enricferrera/PEMY/Fase_Inicial/Calculos_dron.pdf

## Cálculos para estos componentes

Qué tenemos?
Motor brushless A22-12:
- 1000KV -> Cada voltio girará 1000 rpm
- 22mm width of the stator
- 13mm height of the rotor

ESC (Electrónic Speed Controller):
- 30A

Propeller 10-45:
- Diameter: 10 inches → 25,4 cm
- Pitch 4.5 inches → 11.43

Battery 2 options:
- Batería Lipo 3500mAh 2S 25C, 7.4V
- 3500mAh
- 7,4V
- 2s
- 25C → 3,5A*25(1/h) = 87,5A (Max Amp output)
- Energia = 3.5 Ah * 7.4V = 25.9 Wh
- Lipo Batería 5200mAh 2S 50C 7.4V
- 5200mAh
- 7,4V
- 2s
- 50C → 5,2A*50(1/h) = 260A (Max Amp output)
- Energia = 5.2 Ah * 7.4V = 38.48 Wh
Weight: 1kg

## ¿Volará?

Peso del dron

Componente | Peso
RaspBerry pi 4 | 10g
Cámara con autofocus 12MP IMX477 | 5g
Motor brushless * 4 | 120*4 = 480g
Batería Lipo 3500mAh 2S 25C, 7.4V | 215g
Omnibus F4V3S F4 V3 V3S PLUS FC | 18g
Carcasa | 250g
TOTAL: | 978 - aprox 1 kg

## Thrust-to-Weight Ratio (T:W)

Thrust:
1. Determine motor rpm:
- KV: Motor KV Rating
- V: Battery voltage
Formula: KV ⋅ V = RPM → KV = 1000kv · 7,4V = 7400RPM
2. Calculate propeller thrust

T ≈ CT ⋅ ρ ⋅ n

2 ⋅ D

4

Where:

- T: Thrust in Newtons
- CT: Thrust coefficient (typically ranges from 0.1 to 0.2 for common
| hobby props)
- ρ: Air density (approx 1.225 kg/m3 at sea level)
- n: Rotational speed in revolutions per second (RPS)
- D: Propeller diameter in meters

RPM to RPSecond = 7400/60 = 123,33

Ct = 0.15
p = 1.225
n = 123
D = 0.25

T = 0,15 * 1.225 * 123 ^ 2 * 0.25 ^ 4 = 11,57 N

Convert thrust to kilograms (1Kg = 9.81N)
14,47 / 9,81 = 1,179kg

Total thrust for 4 motors = 1,352kg * 4 = 4.6996kg

Thrust to weight ratio = 4.6kg / 1kg = 4.6kg

# Induced Velocity at Hover (vi,h )

Weight (m): 1kg (1000g from our example above)

Propeller Radius (rprop

): 0.125 (0.25 diameter from our 10" example above/2)

Air Density (ρ): 1.225 kg/m³ (approx at sea level)

Gravitational Force (g): 9.81 m/s

2
(constant)

Number of Rotors (Nr): 4 (4 total motors)

## Step-by-step calculation:

Formula: vi,h

= √ ( Th
/ 2ρAprop

) = √ (mg / 2ρπr
2
propNr)

### 1. Calculate the Thrust Required to Hover (Th):

Th = mg = 1 ⋅ 9.81 ≈ 9.81 N

### 2. Calculate the Propeller Area (Aprop):

Aprop = πr

2

prop = π(0.125)² ≈ π ⋅ 0.015625 = 0.049087 m²

### 3. Insert the Values into the Formula:

vi,h

= √ 9.81/ 2 ⋅ 1.225 ⋅ π ⋅ 0.015625 ⋅ 4

Simplify for Induced Velocity at Hover:

vi,h

= √ 6.867 / 0.48105 ≈ √16.81 ≈ 4.51 m/s

# 3. Hover Power (Ph )

## What variables do you need:

Weight (m): 1 (1000g from our example above)

Gravitational Force (g): 9.81 m/s²
(constant)

Air Density (ρ): 1.225 kg/m³ (approx at sea level)

Propeller Radius (rprop

): 0.125 (0.13 diameter from our 5" example above/2)

Number of Rotors (Nr): 4 (4 total motors)

Propeller Efficiency (ηP): 0.6 (typical assumption for small multicopter propellers)

Thrust Required to Hover (Th

): 9,81N (calculated from previous formula)

Induced Velocity at Hover (vi,h

): 4.51 m/s (calculated from previous formula)

## Step-by-step calculation:

Formula: Ph = Thvi,hNr / ηP

### 1. Insert Values into the Formula:

Ph = (9,81 ⋅ 4.51 ⋅ 4) / 0.6

### 2. Simplify for Hover Power:

Ph = 176.97 / 0.6 ≈ 294.95 W

# 4. Power at Optimal Endurance (Pe ) and Optimal Range (Pr )

Hover power: 294.95W (calculated above)

Power consumption for optimal endurance: 91.4% (constant derived from studies and experiments on multicopter performance)

Power consumption for optimal range: 109.2% (constant derived from studies and experiments on multicopter performance)

## Step-by-step calculation:

### 1. Calculate Power at Optimal Endurance (Pe

):

Pe = 0.914 ⋅ 294.95 ≈ 269.58 W

### 2. Calculate Power at Optimal Range (Pr ):

Pr = 1.092 ⋅ 294.95 ≈ 322.08 W

# 5. Electric Power Demand (Pmot,e

),

### (Pmot,r )

## What variables do you need:

Power at Optimal Endurance (Pe

): 269.58 W (calculated above)

Power at Optimal Range (Pr ): 322.08 W (calculated above)

Motor Efficiency (ηM): 0.75 (assumed, typical value for electric motors)

## Step-by-step calculation:

### 1. Calculate Electric Power Demand at Optimal Endurance (Pmot,e

):

Formula: (Pmot,e

) = Pe

/ ηM

Insert values into formula:

(Pmot,e

) = 269.58 / 0.75 ≈ 359.44 W

### 2. Calculate Electric Power Demand at Optimal Range (Pmot,r):

Formula: (Pmot,r) = Pr / ηM

Insert values into formula:

(Pmot,r) = 322.08 / 0.75 ≈ 429.44 W

# 6. Normalized Power Consumption (Pcell,e

), (Pcell,r )

## What variables do you need:

Power Demand at Optimal Endurance (Pmot,e

): 359.44W (calculated
above)

Power Demand at Optimal Range (Pmot,r): 429.44 W (calculated above)

Battery Cell Count (Ncell): 2 (based on the battery we picked)

Battery Capacity (Cbatt): 3500 mAh (based on the battery we picked)

## Step-by-step calculation:

### 1. Convert Battery Capacity from mAh to Ah:

Cbatt = 3500 mAh / 1000 = 3.5 Ah

### 2. Calculate Normalized Power Consumption at Optimal Endurance

(Pcell,e

):

Formula: Pcell,e = Pmot,e

/ (Ncell ⋅ Cbatt )

Insert values into formula:

Pcell,e = 359.44 / (2 ⋅ 3.5 ) = 359.4/ 7 ≈ 51.34 W / Ah

3 . Calculate Normalized Power Consumption at Optimal Range (Pcell,r):

Formula: Pcell,r = Pmot,r / (Ncell ⋅ Cbatt )

Insert values into formula:

Pcell,r = 429.44/ (2 ⋅ 3.5 ) = 429.44 / 7 ≈ 61.34 W / Ah

# 7. Effective Battery Capacity (κe

),
(κr )

## What variables do you need:

Normalized Power Consumption at Optimal Endurance (Pcell,e

): 51.34 W
/ Ah (calculated above)

Calculate Normalized Power Consumption at Optimal Range (Pcell,r): 61.34 W / Ah (calculated above)

Polynomial coefficients for effective capacity (assumed, based on empirical data)
d0

: Constant term = 1.0
d1

: Linear term coefficient = -0.01
d2

: Quadratic term coefficient = 0.0005 d3

: Cubic term coefficient = -0.00001

## Step-by-step calculation:

### 1. Calculate Battery Capacity at Optimal Endurance (κe

):

Formula: κe = d0 + d1Pcell,e + d2P

2
cell,e + d

3
cell,e

Insert values into formula:
κe = 1.0 + (-0.01 ⋅ 51.34) + (0.0005 ⋅ 51.34²

) + (-0.00001 ⋅ 51.34³
)

Simplify:
κe = 1 - 0.5134 + 1.3178 - 1.3532≈ 0.4512

### 2. Calculate Battery Capacity at Optimal Range (κr):

Formula: κr = d0 + d1Pcell,r + d2P

2
cell,r + d

3
cell,r

Insert values into formula:
κr = 1.0 + (-0.01 ⋅ 61.34) + (0.0005 ⋅ 61.34²

) + (-0.00001 ⋅ 61.34³
)

Simplify:
κr = 1 -0.6134 + 1.8813.- 2.3079≈ -0.04

# 8. Maximum Endurance and Flight Time (te

), (tr )

## What variables do you need:

Effective Battery Capacity at Optimal Endurance (κe

): 0.4512
(calculated above)

Effective Battery Capacity at Optimal Range (κr): -004(calculated above)

Electric Power Demand at Optimal Endurance (Pmot,e

): 359.44 W
(calculated above)

Electric Power Demand at Optimal Range (Pmot,r): 429.44 W (calculated above)

Battery Cells (Ncell): 2 (based on the battery we picked)

Battery Capacity (Cbatt): 3500 mAh (based on the battery we picked)

Nominal Cell Voltage: 3.7 V (constant)

## Step-by-step calculation:

### 1. Convert Battery Capacity from mAh to Ah:

Cbatt = 3500 mAh / 1000 = 3.5 Ah

### 2. Calculate Total Effective Battery Capacity in Watt-hours (Wh):

For Endurance:

Formula: Ceff,e = κe ⋅ Cbatt ⋅ Ncell ⋅ 3.7 V Ceff,e = 0.4512 ⋅ 3.5 ⋅ 2 ⋅ 3.7 ≈ 11.68 Wh

For Range:

Formula: Ceff,r = κr ⋅ Cbatt ⋅ Ncell ⋅ 3.7 V Ceff,r = 0.01 ⋅ 1.5 ⋅ 4 ⋅ 3.7 ≈ 14.13 Wh

### 3. Calculate Maximum Endurance (te

):

Formula: te = ( Ceff,e ⋅ 3600 seconds in an hour) / Pmot,e
te = 11.68 ⋅ 3600 / 359.44≈116.98 seconds ≈ 1.94 minutes

### 4. Calculate Flight Time at Maximum Range (tr):

Formula: tr = ( Ceff,r ⋅ 3600 seconds in an hour) / Pmot,r tr = 14.13 ⋅ 3600 / 273.40 ≈ 186 seconds ≈ 3.1 minutes
