enricferrera/PEMY/Fase_Inicial/PEMY_RLP_Budget.xlsx - Bricogeek.pdf

Name | | Price | Units | | Total
Raspberry Pi Zero | (€ | 33,82) | 1,00 | (€ | 33,82)
Cámara con autofocus 12MP IMX477 * | (€ | 108,78) | 1,00 | (€ 108,78)
Motor brushless | (€ | 26,49) | 4,00 | (€ 105,96)
Batería Lipo 3500mAh 2S 25C, 7.4V | (€ | 20,19) | 1,00 | (€ | 20,19)
Omnibus F4V3S F4 V3 V3S PLUS FC | (€ | 15,20) | 1,00 | (€ | 15,20)
Módulo GPS NEO GY-GPS6MV2 | (€ | 8,58) | 1,00 | (€ | 8,58)
Tarjeta MicroSD Kingston 128GB * | (€ | 12,95) | 1,00 | (€ | 12,95)
TOTAL | (€ 305,48)

* Peces que no tenim i necessitem

URL
https://tienda.bricogeek.com/placas-raspberry-pi/1082-kit-basico-raspberry-pi-zero-wifi-microsd-32gb.html
https://tienda.bricogeek.com/camaras/1586-camara-con-autofocus-12mp-imx477.html
https://www.amazon.es/KEESIN-Brushless-Propeller-Accesorios-Quadcopter/dp/B07BS7DFW3https://www.aliexpress.com/p/tesla-landing/index.html?productId=33031000993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 https://es.aliexpress.com/item/1005008077679243.html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
https://www.turibot.es/modulo-gps-gy-gps6mv2-para-arduino-2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
https://tienda.bricogeek.com/accesorios-raspberry-pi/1760-memoria-microsd-kingston-128gb-clase-10-740617298703.html
