enricferrera/PEMY/images/Dron.jpg

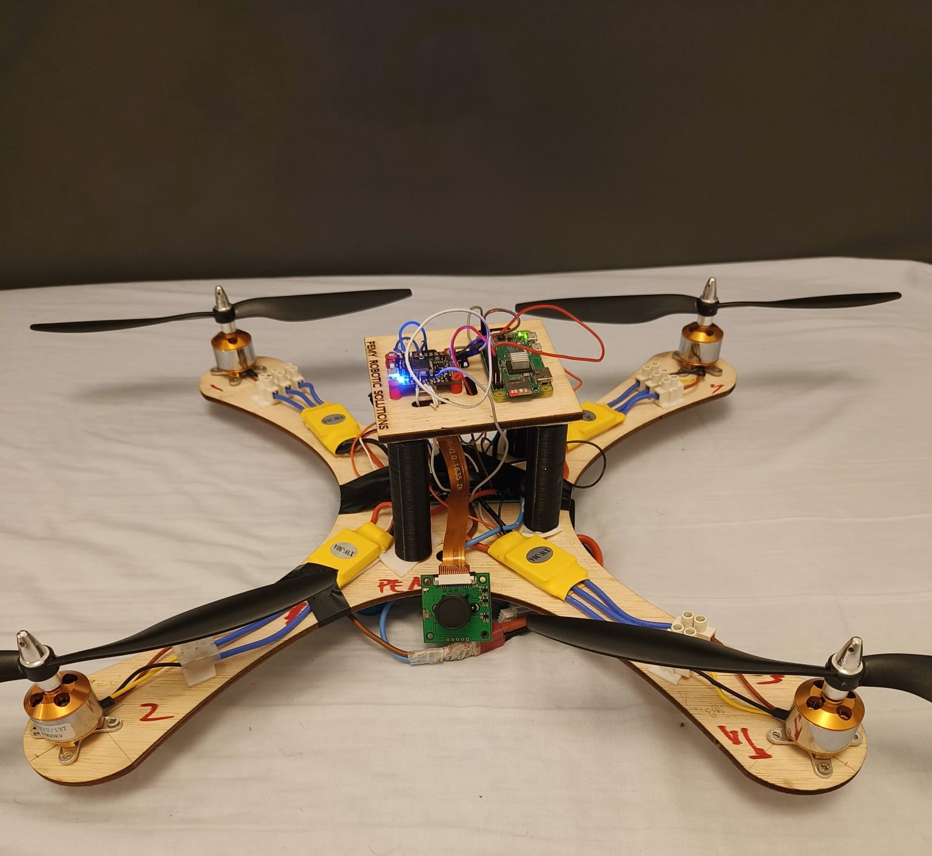
images/Dron.jpg
