enricferrera/PEMY/Disseny3D/NewFrame-Body.stl

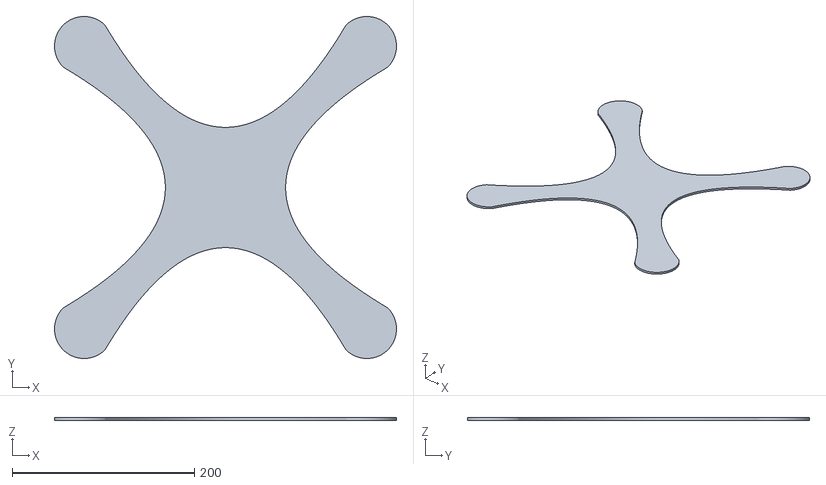
[picture p10: CAD file, 2025-06-26]
Disseny3D/NewFrame-Body.stl
375.0 x 375.0 x 3.00
