enricferrera/PEMY/Disseny3D/NewControllerHolder-Body.stl

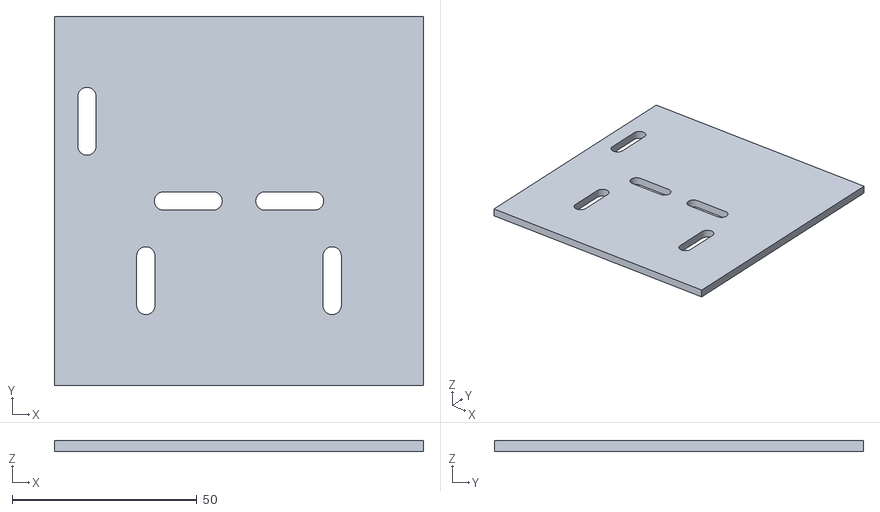
[picture p11: CAD file, 2025-06-26]
Disseny3D/NewControllerHolder-Body.stl
100.0 x 100.0 x 3.00
